Jaycar-Electronics/Wall-Dodging-Robot/images/attaching-wheels.png

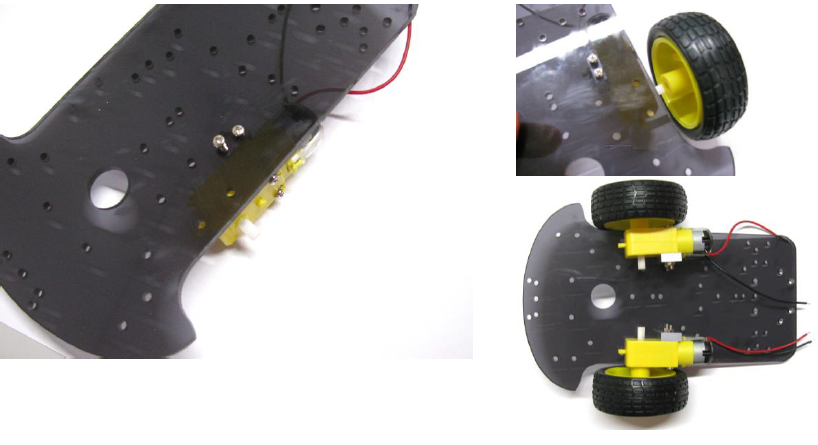
images/attaching-wheels.png
