Jaycar-Electronics/Wall-Dodging-Robot/images/cable.jpg

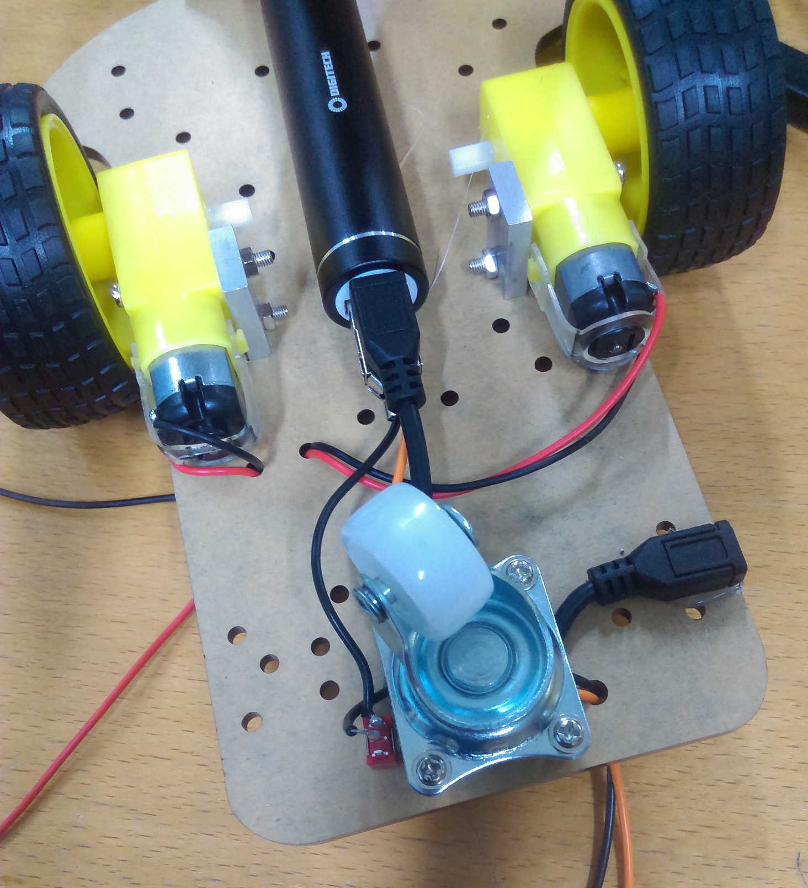
images/cable.jpg
