Jaycar-Electronics/Wall-Dodging-Robot/images/headers.jpg

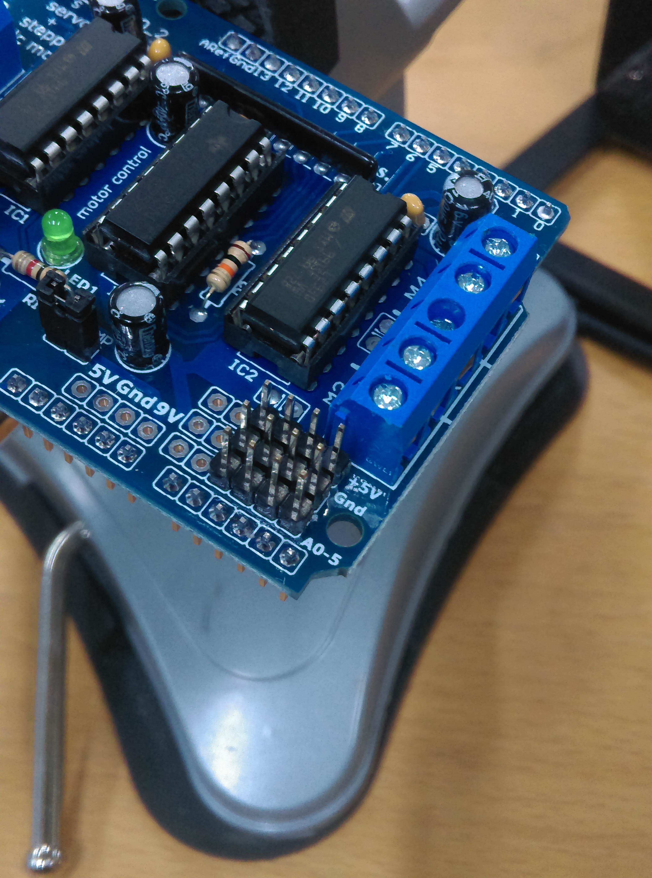
images/headers.jpg
