Jaycar-Electronics/Wall-Dodging-Robot/images/motor-mount.jpg

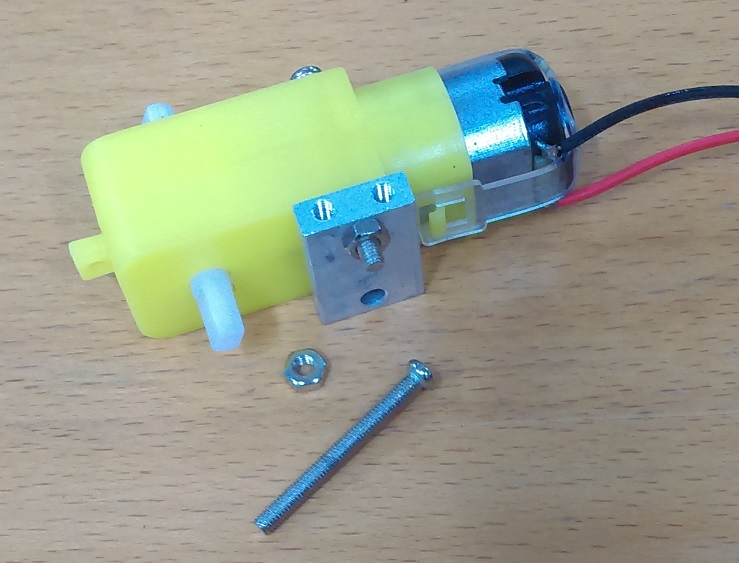
images/motor-mount.jpg
