Jaycar-Electronics/Wall-Dodging-Robot/images/mounting.jpg

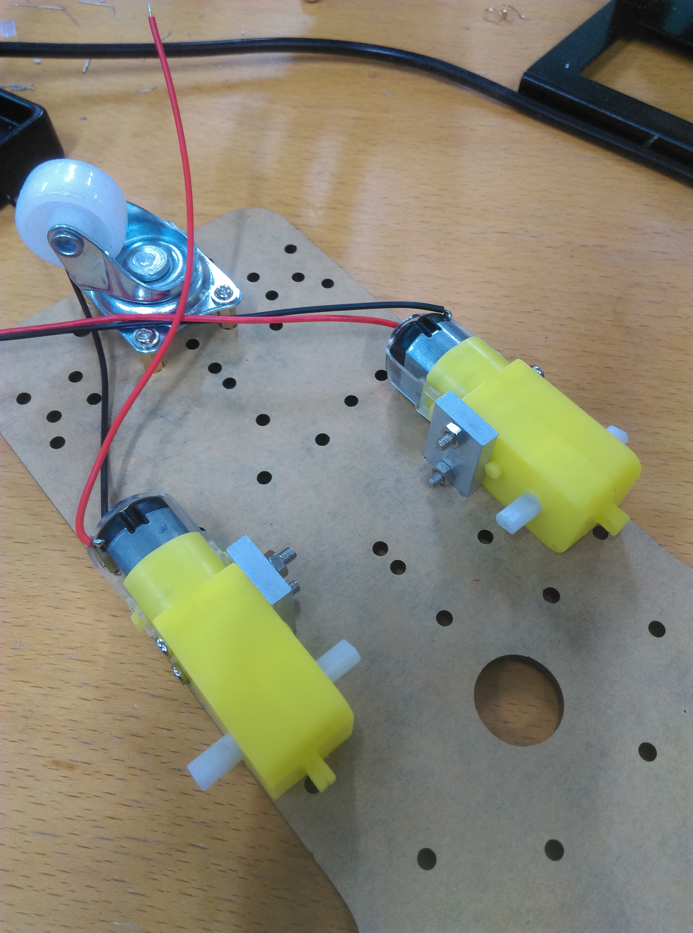
images/mounting.jpg
