Jaycar-Electronics/Wall-Dodging-Robot/images/tighten-the-wheel.png

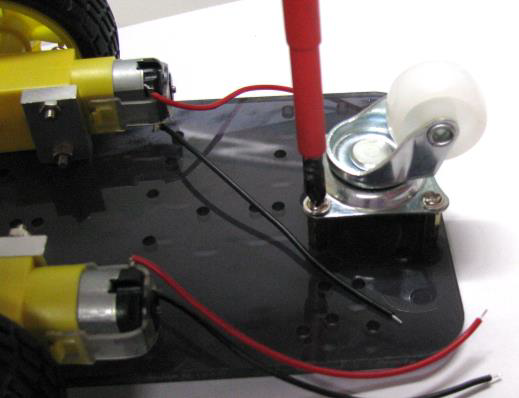
images/tighten-the-wheel.png
