Jaycar-Electronics/Wall-Dodging-Robot/images/topmounting.jpg

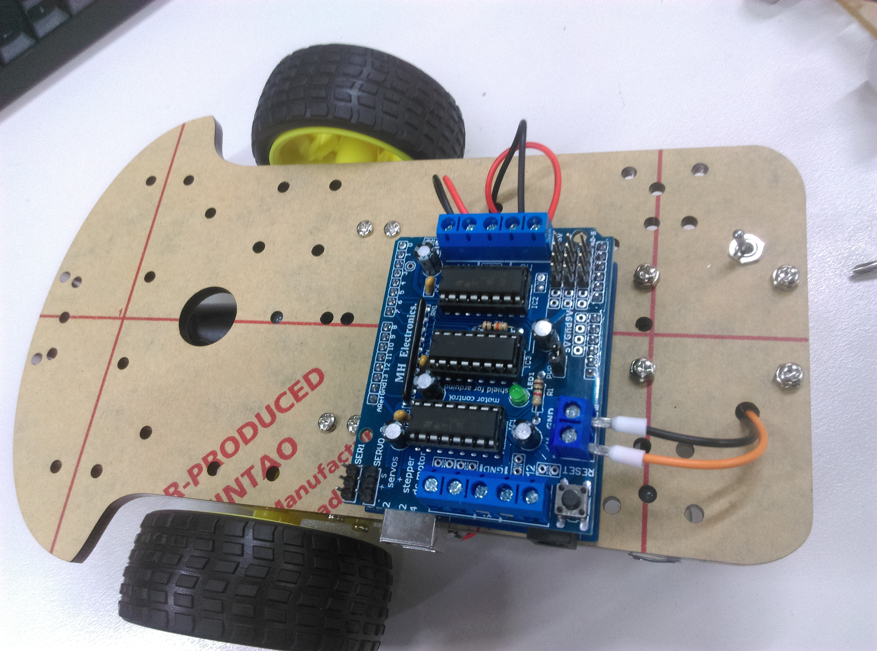
images/topmounting.jpg
