Jaycar-Electronics/Wall-Dodging-Robot/images/wheel-position.jpg

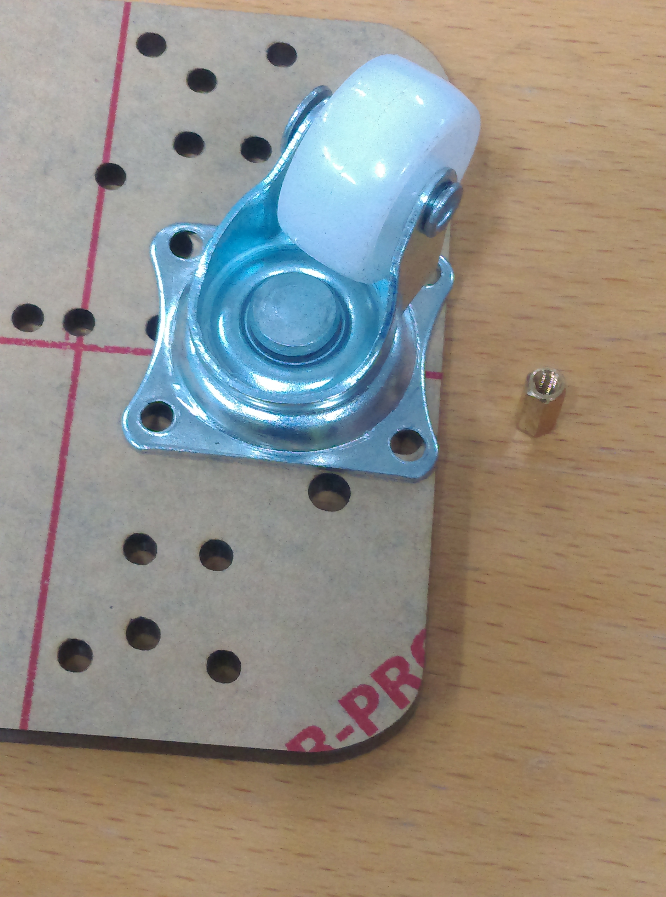
images/wheel-position.jpg
