Jaycar-Electronics/Wall-Dodging-Robot/images/components.jpg

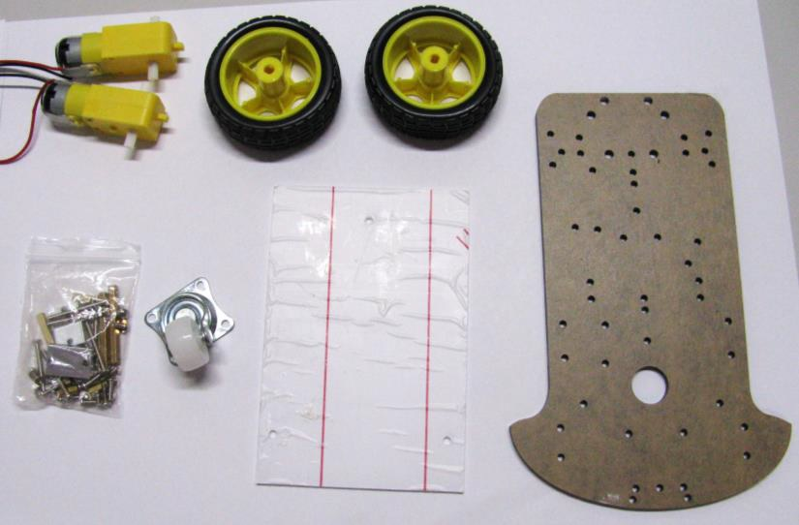
images/components.jpg
