Jaycar-Electronics/Wall-Dodging-Robot/images/solder2.jpg

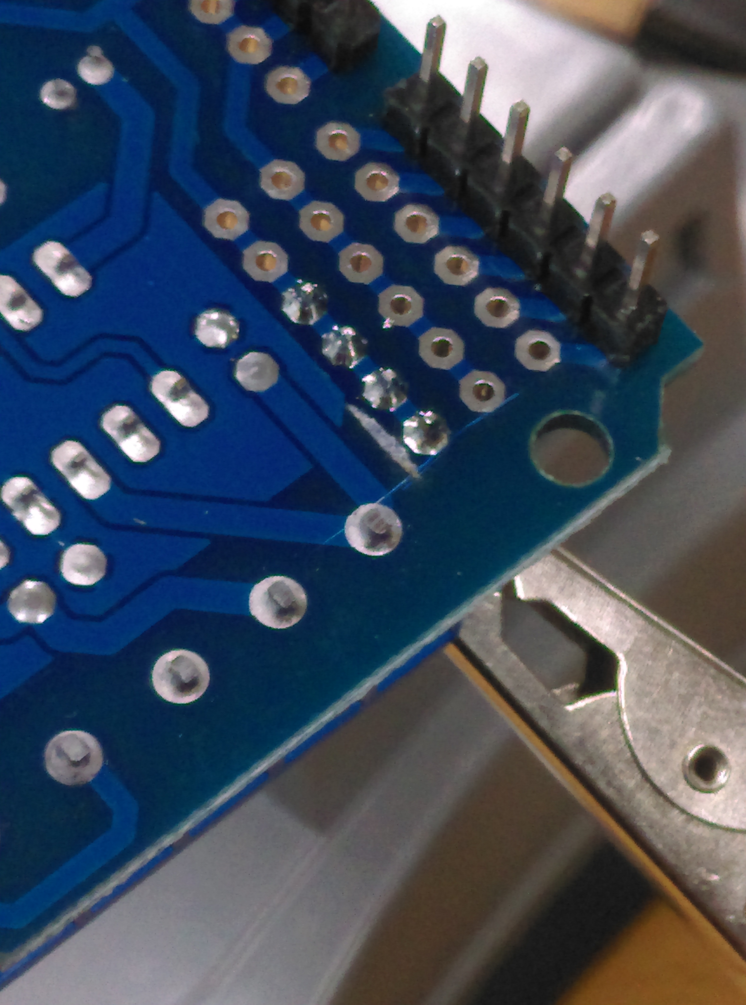
images/solder2.jpg
