Jaycar-Electronics/Wall-Dodging-Robot/(threads)

Thread 2 (2022-05-29):

fatal error: AFMotor.h: No such file or directory

voltrevo, 2022-05-29:
When I open `robotCode.ino` in the [arduino ide](https://www.arduino.cc/en/Guide/macOS) and click the verify button, I get this compilation error.

Is there a guide somewhere for setting up the environment correctly? Should I install some library that defines `AfMotor.h`?

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

voltrevo, 2022-05-29:
This seemed to be resolved by going to Tools->Manage Libraries, searching "Adafruit Motor Shield Library" and installing 1.0.1.

However, after uploading to the arduino, my robot no longer moves after disconnecting from usb and reinstalling the batteries. Just some blinking lights. (My kit was preloaded and worked as intended before uploading any code.)
